microresearch/mycelium/01positive.jpg

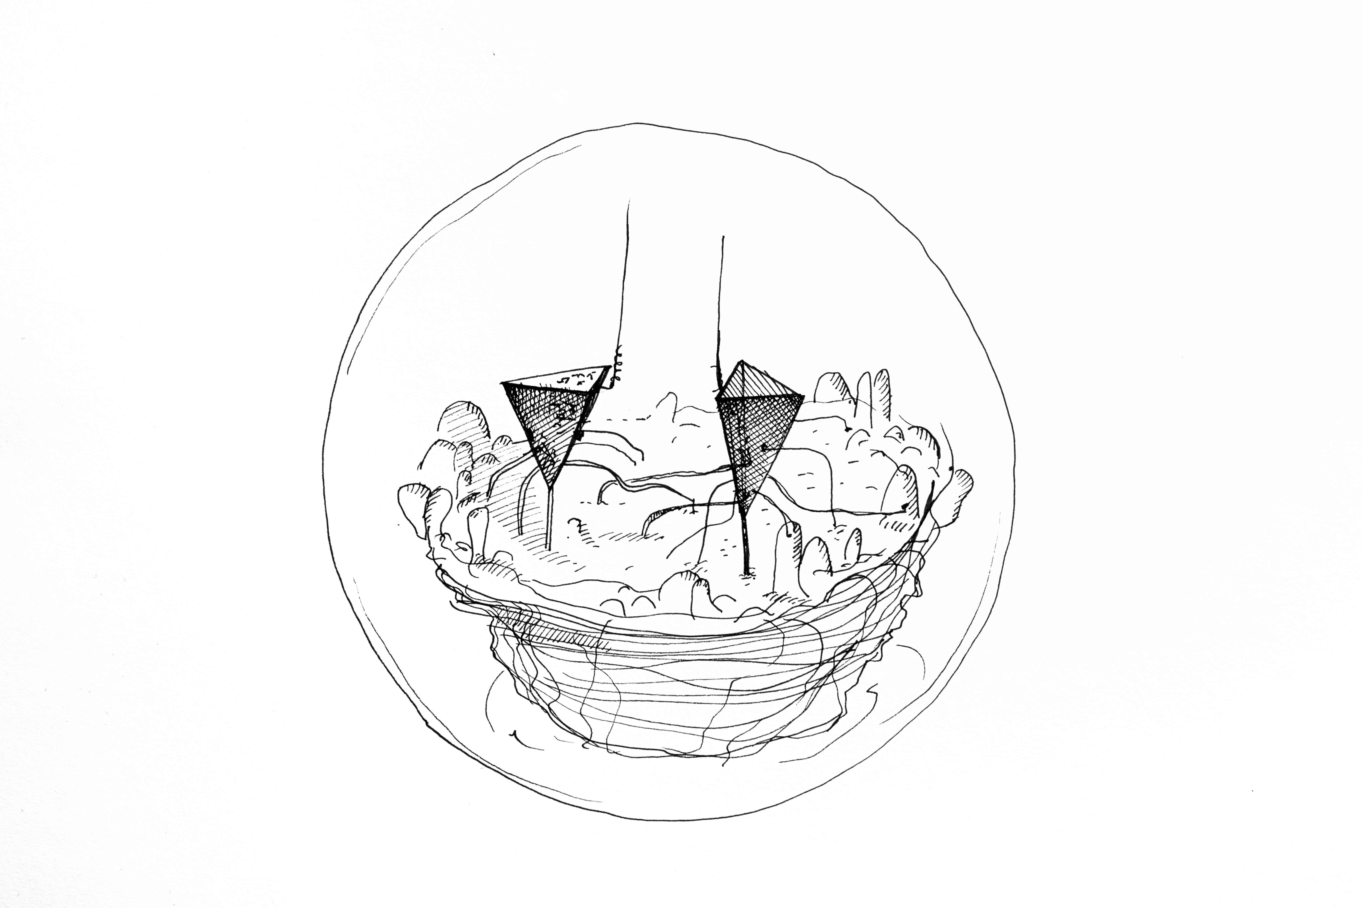
01positive.jpg
