microresearch/mycelium/simplestTX00.jpg

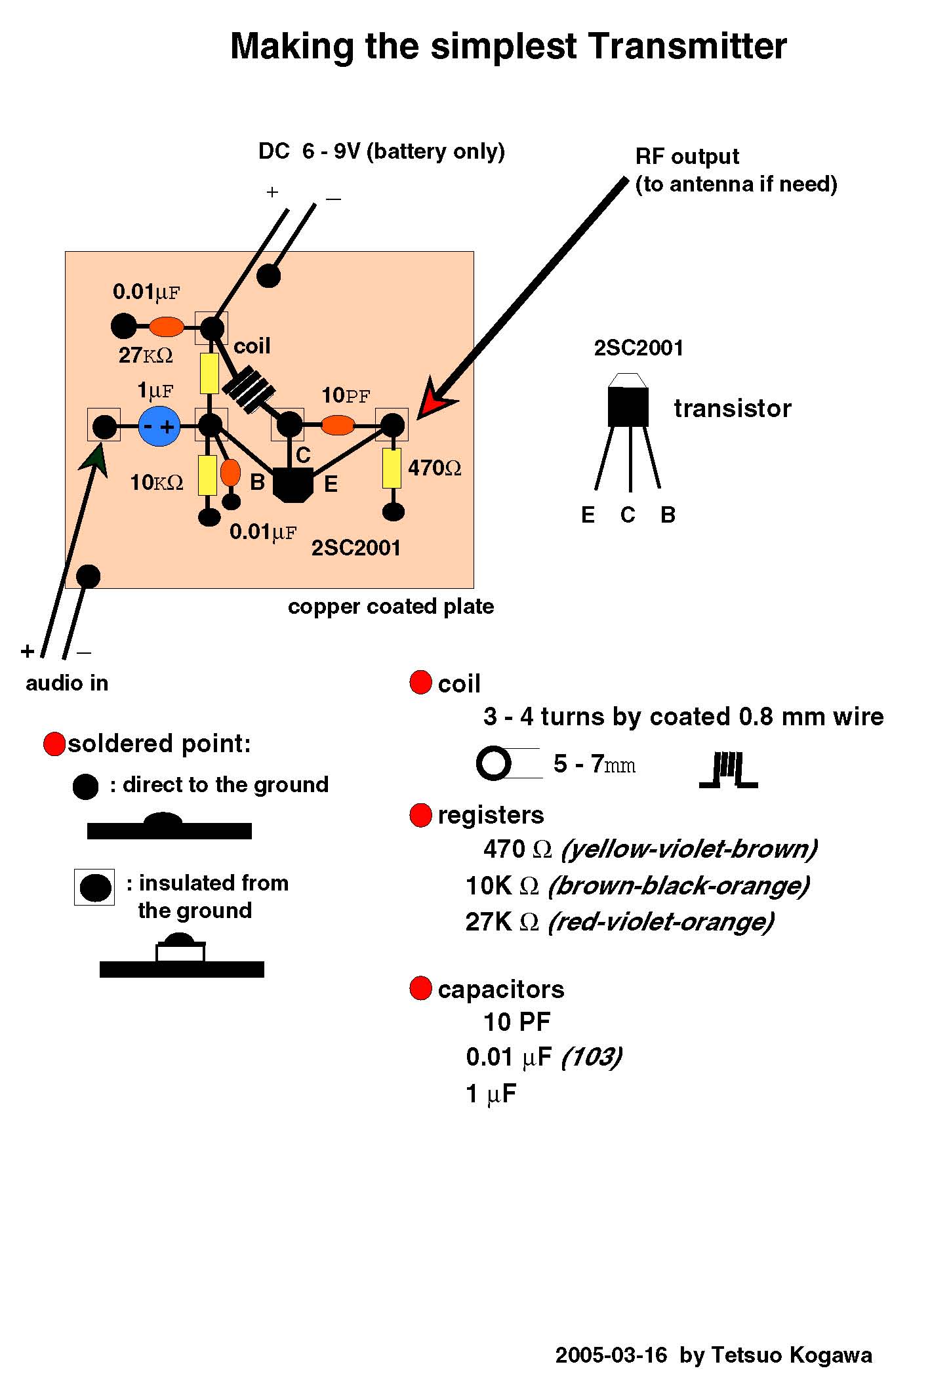
simplestTX00.jpg
