microresearch/mycelium/spy7-1.png

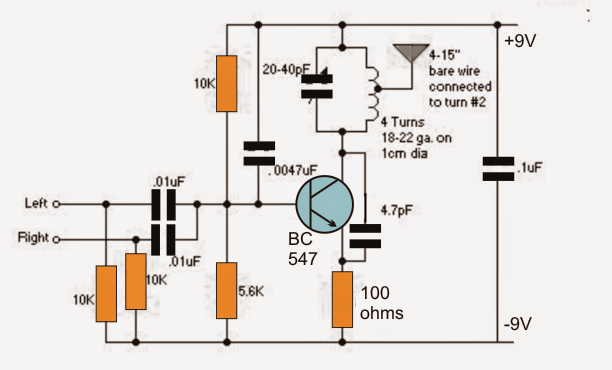
spy7-1.png
