microresearch/mycelium/myc_outline2.dxf

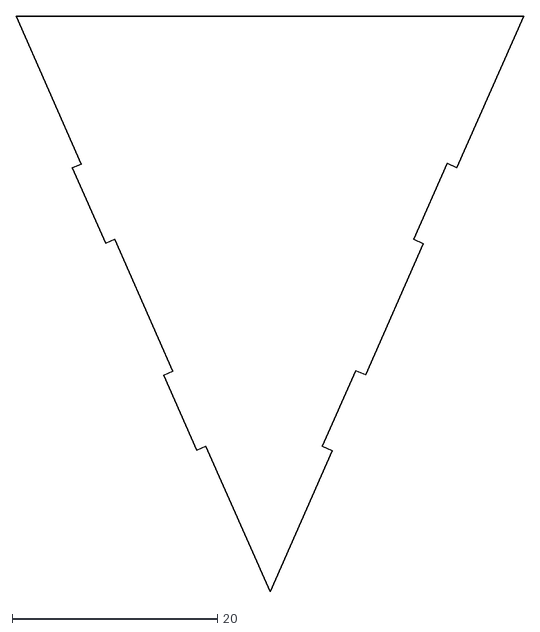
[picture p4: CAD file, 2018-06-28]
myc_outline2.dxf
49.5 x 56.1
