microresearch/mycelium/myc_outline3.dxf

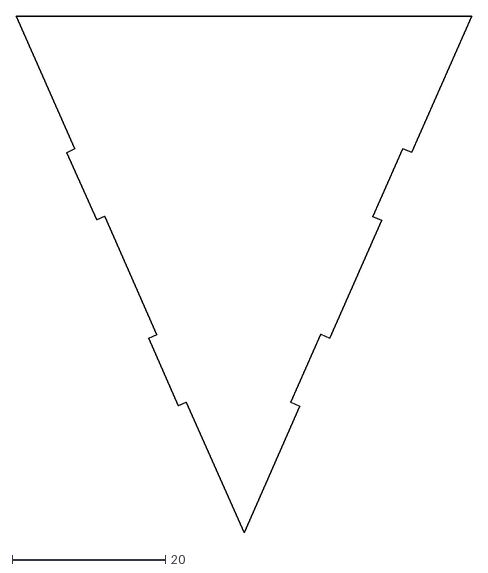
[picture p5: CAD file, 2018-06-28]
myc_outline3.dxf
59.4 x 67.4
