microresearch/mycelium/myc_small_schematic.pdf

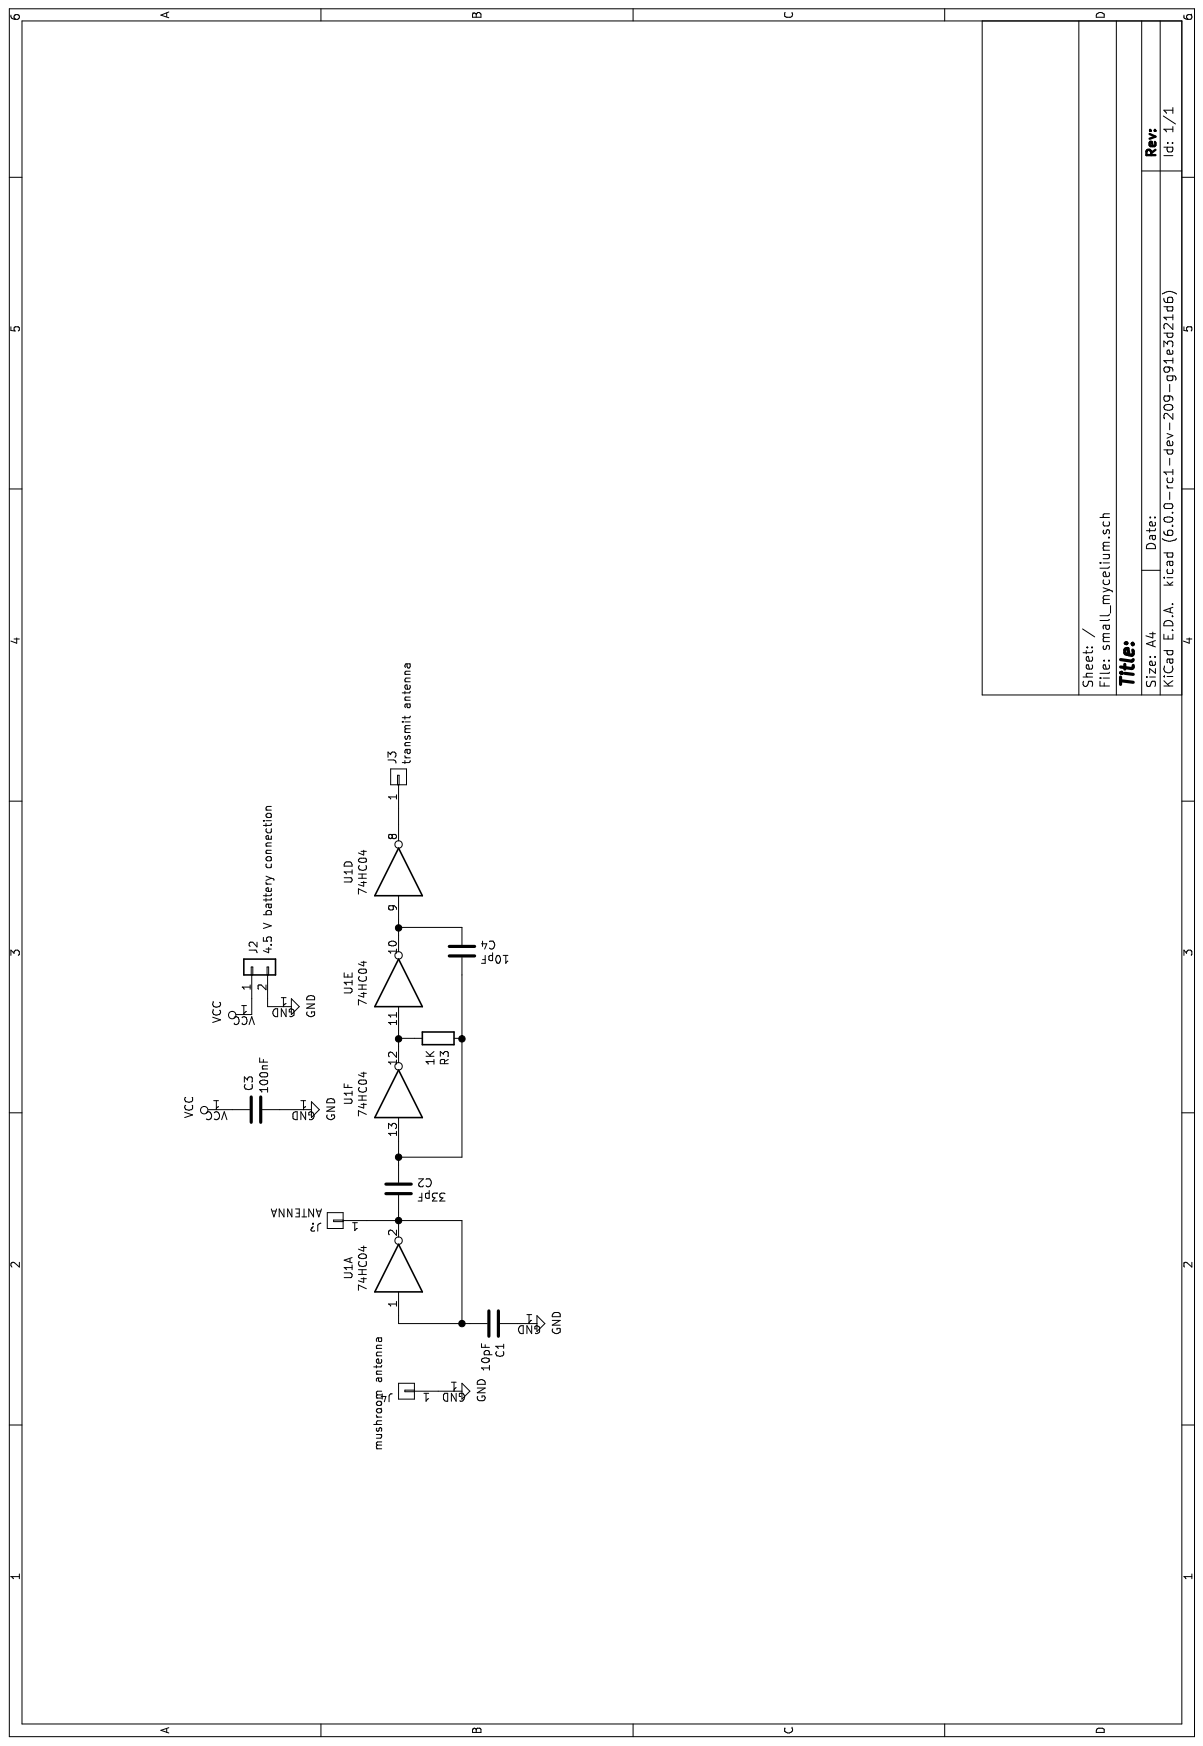
[picture p6: page 1]
