microresearch/mycelium/mycelium_pcb/earthboot/earthboot_schematic.pdf

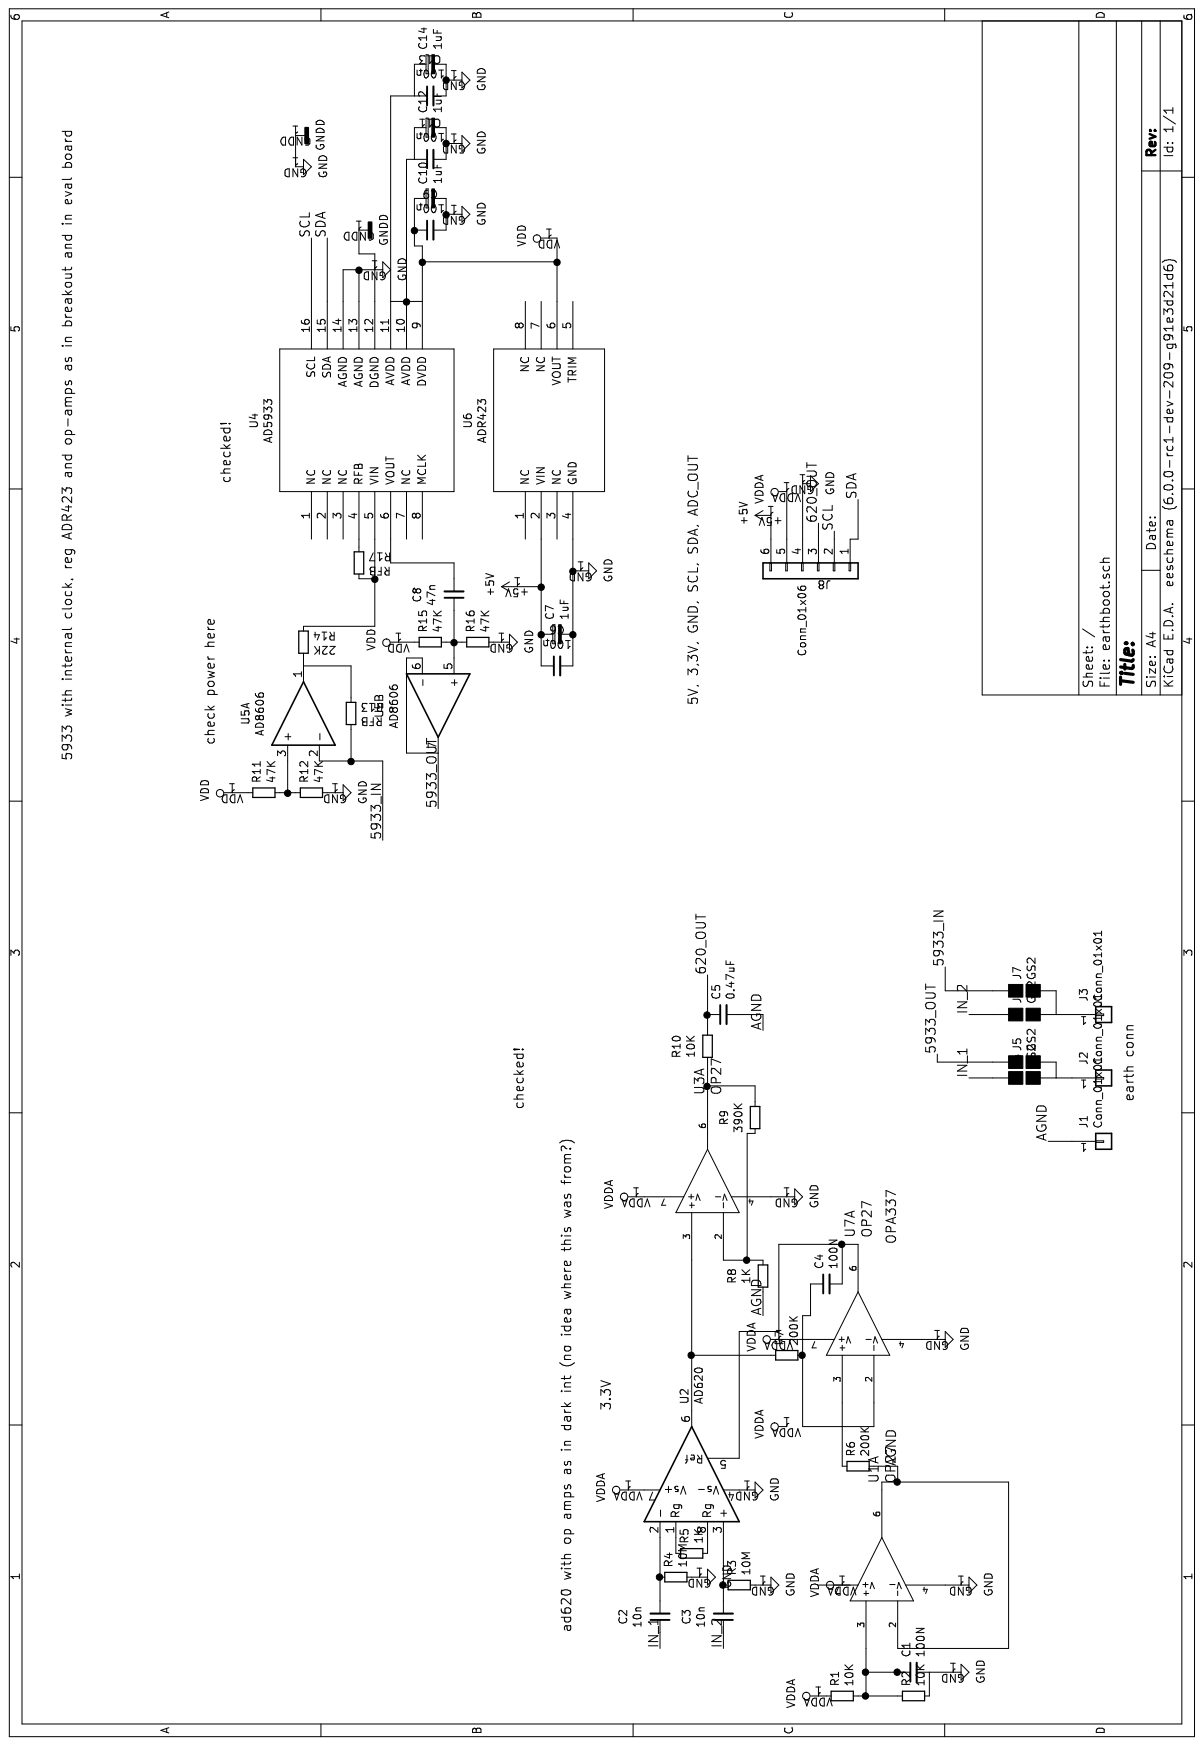
[picture p10: page 1]
