microresearch/mycelium/myc_small.pdf

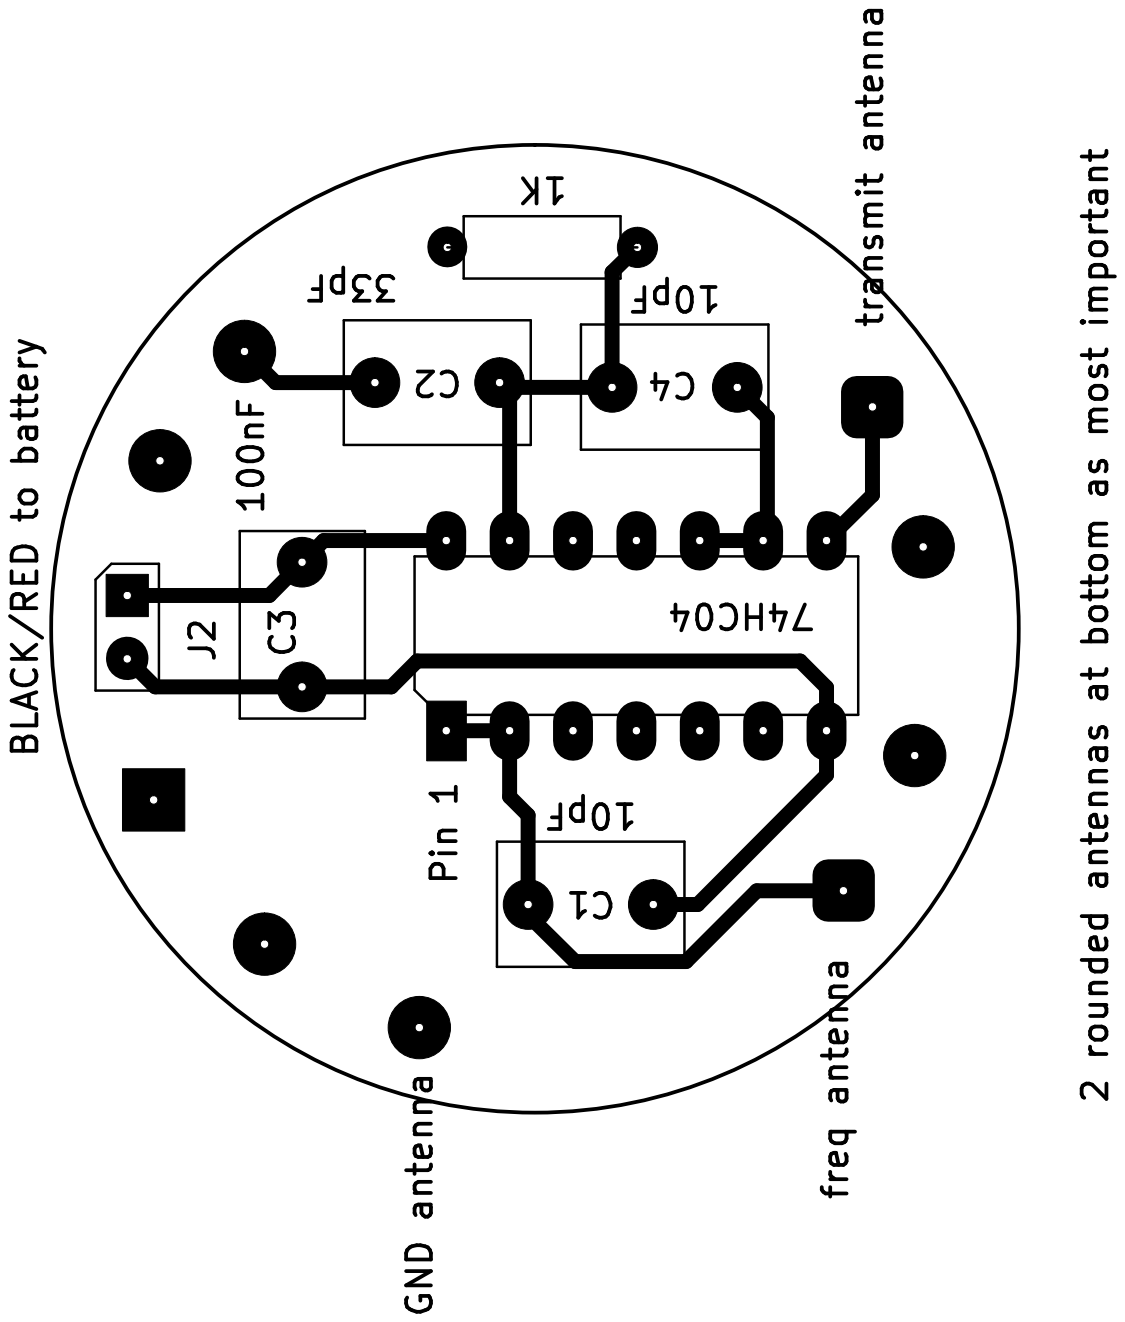
[picture p11: page 1]
