microresearch/mycelium/mycelium_pcb/mycelium_pcb_radio-F.SilkS.pdf

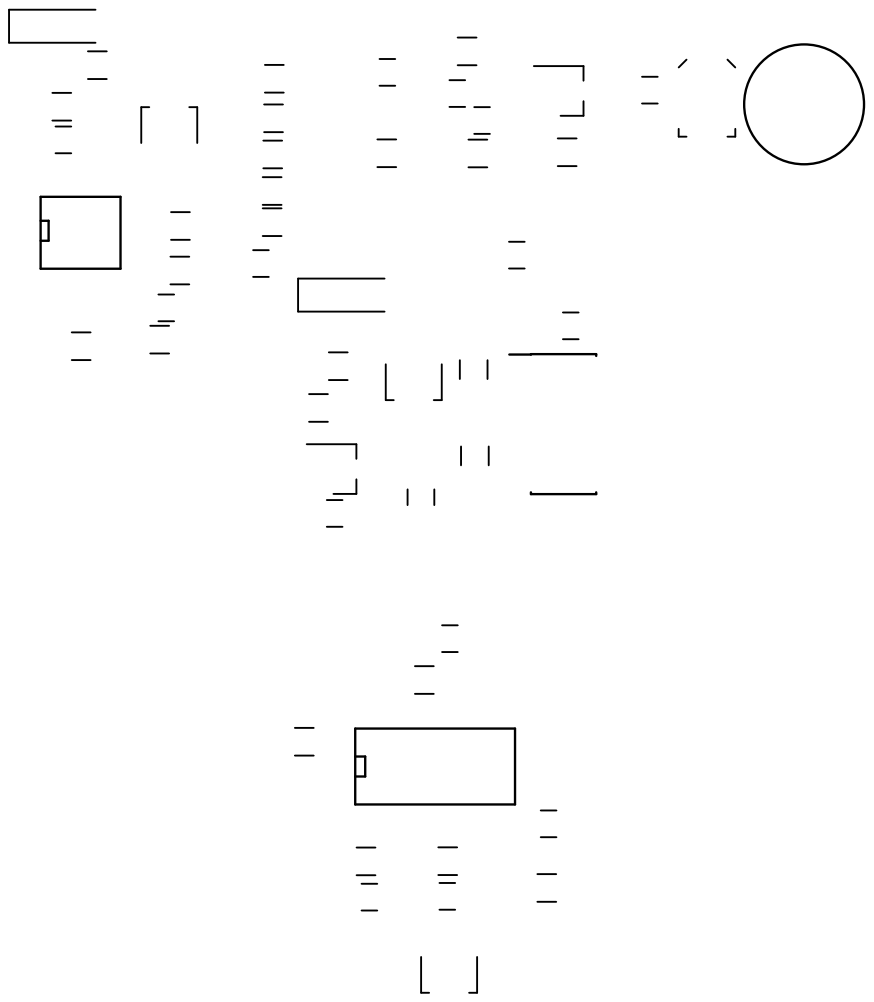
[picture p12: page 1]
