microresearch/mycelium/mycelium_pcb/micro.pdf

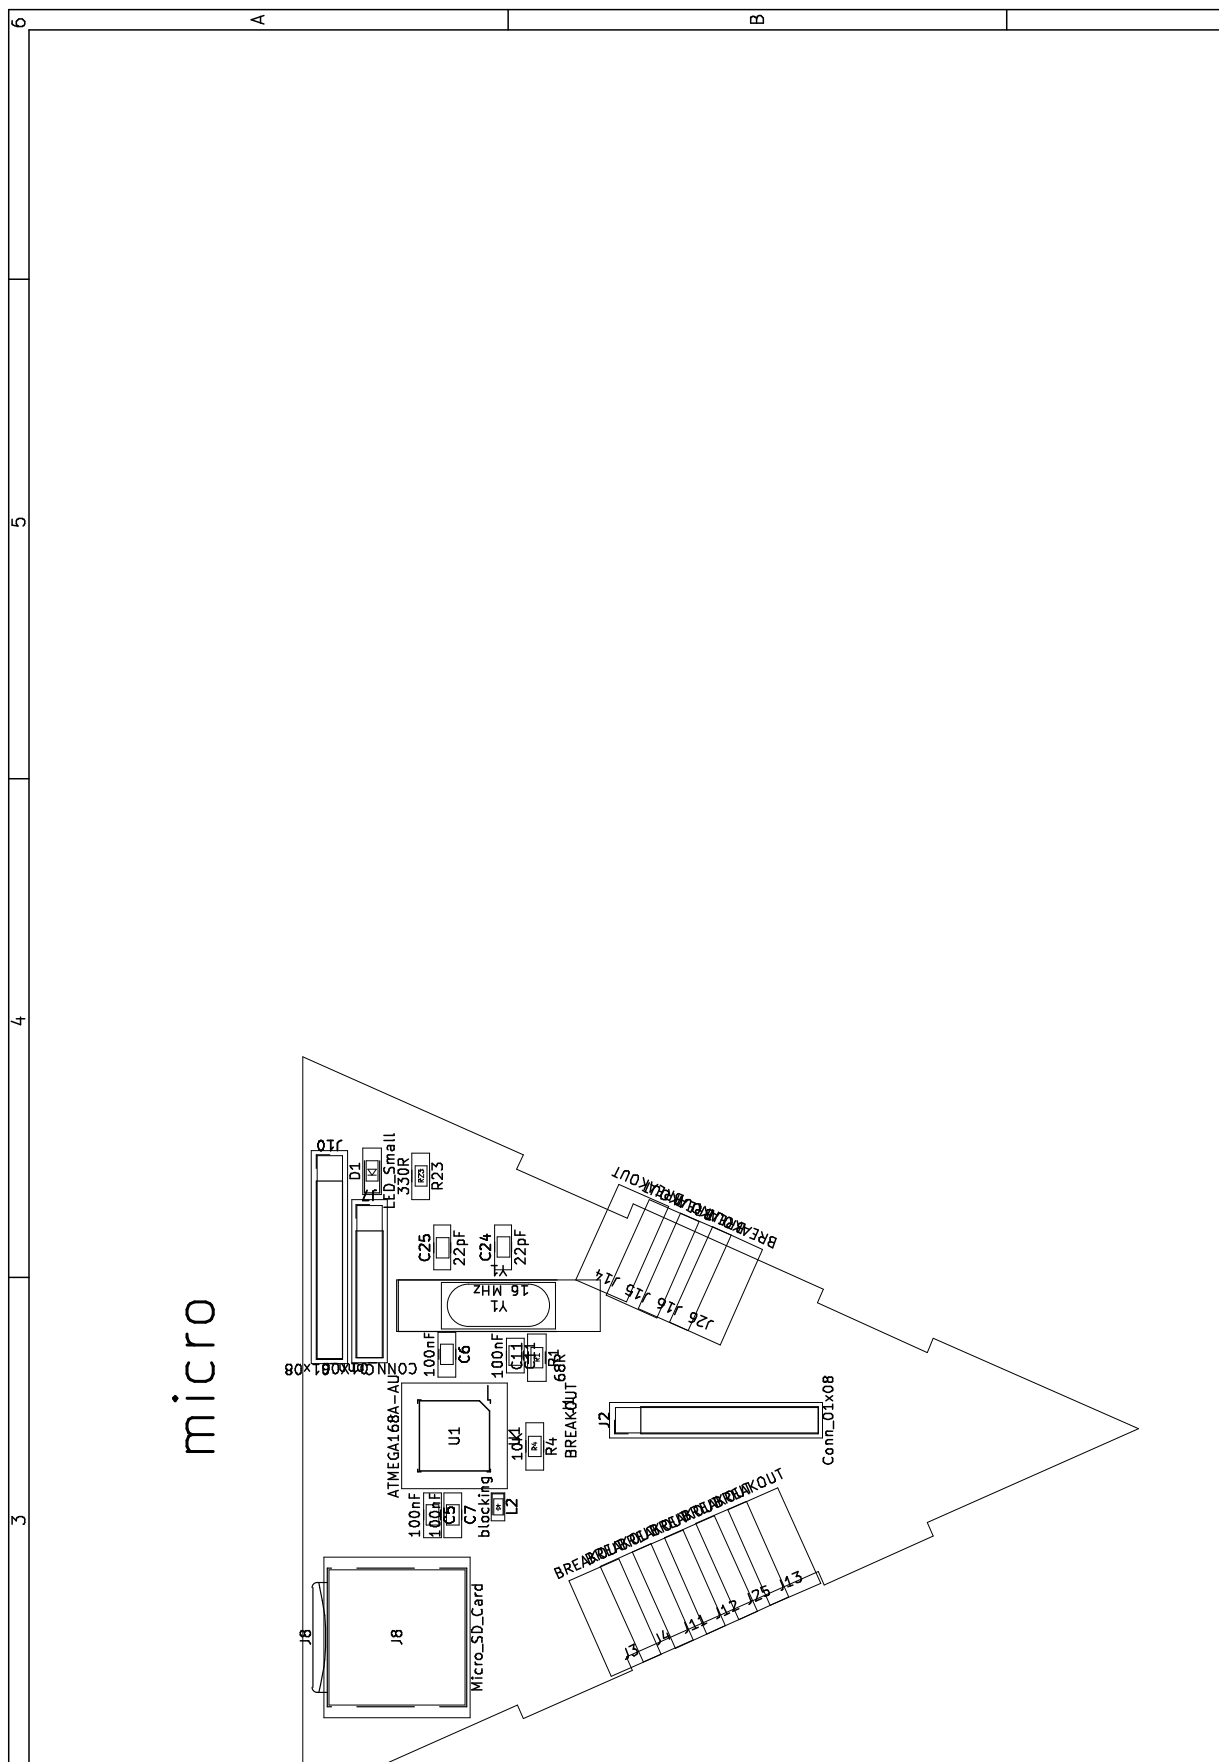
[picture p13: page 1]
