microresearch/mycelium/mycelium_pcb/radio.pdf

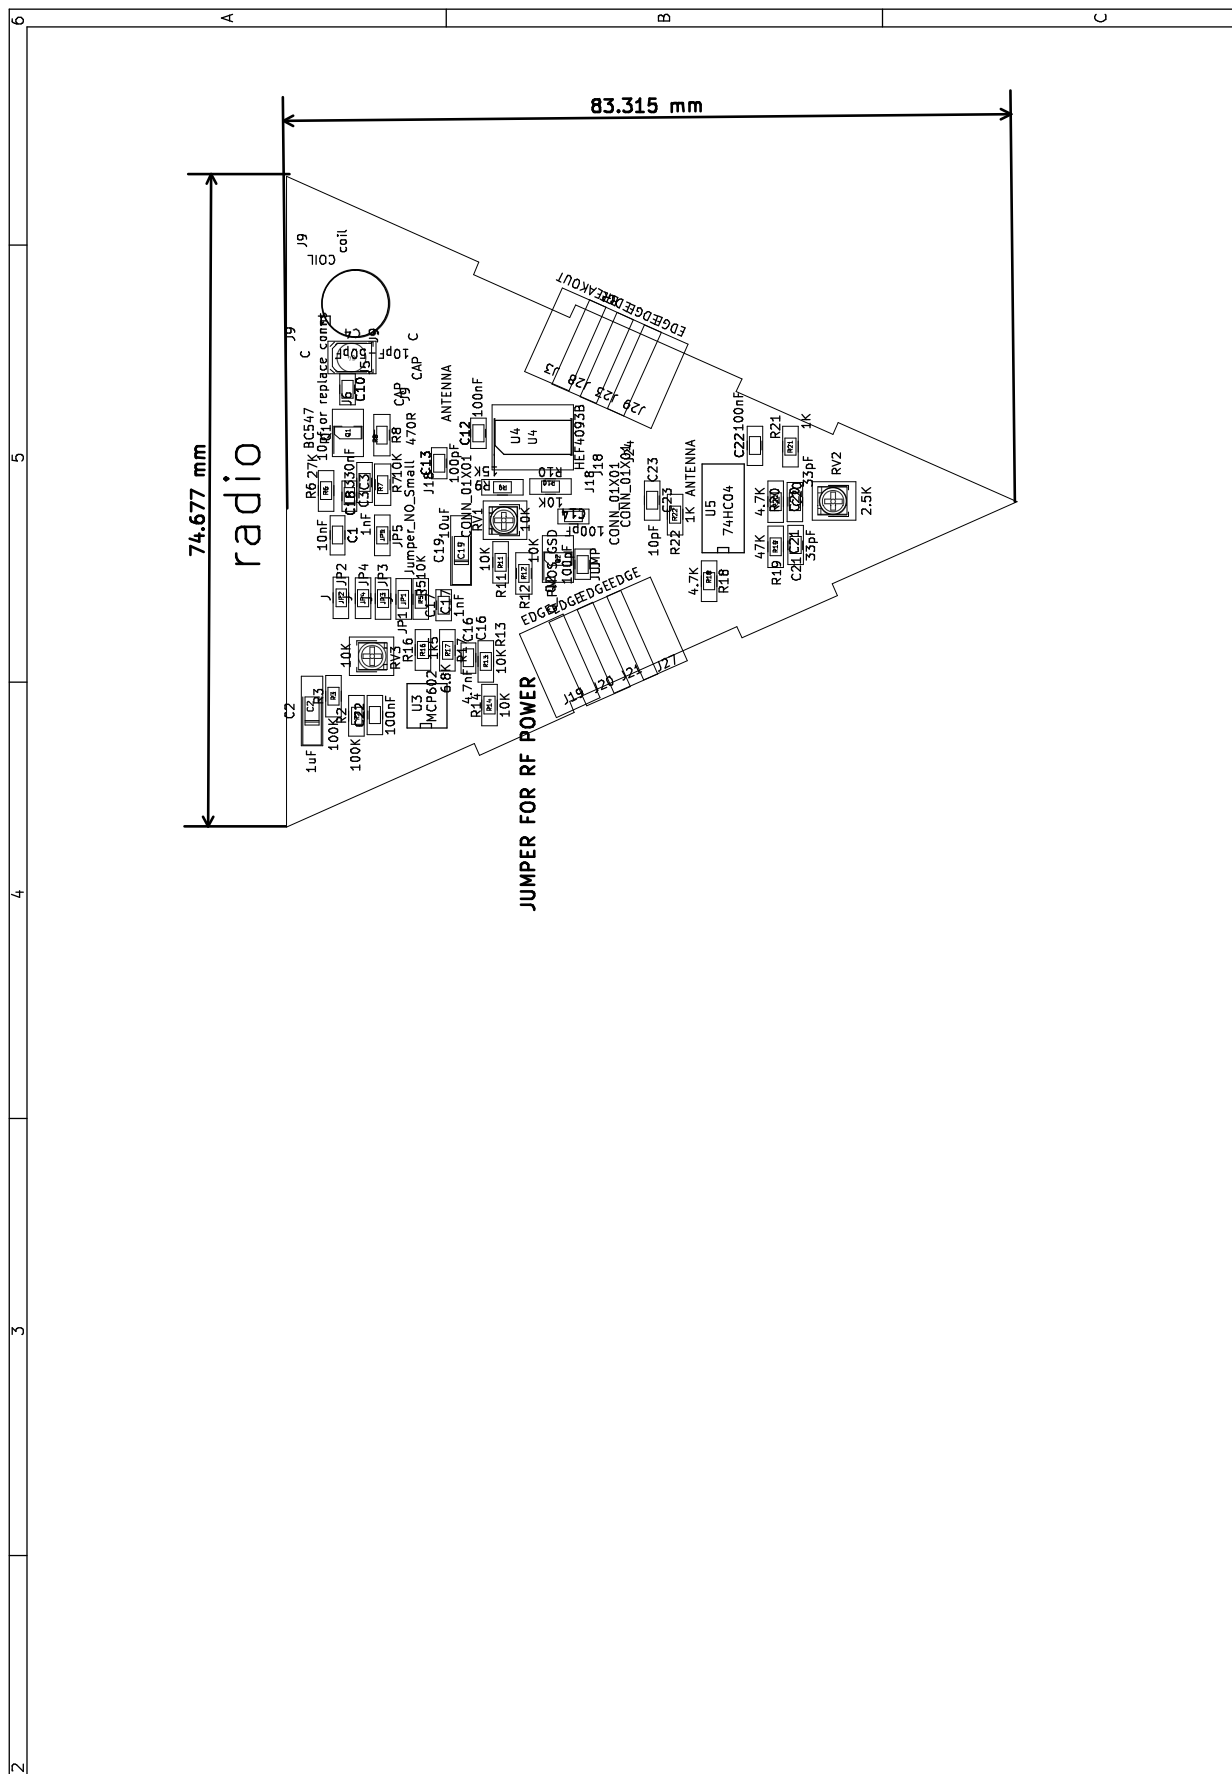
[picture p14: page 1]
