microresearch/mycelium/mycelium_pcb/sensor.pdf

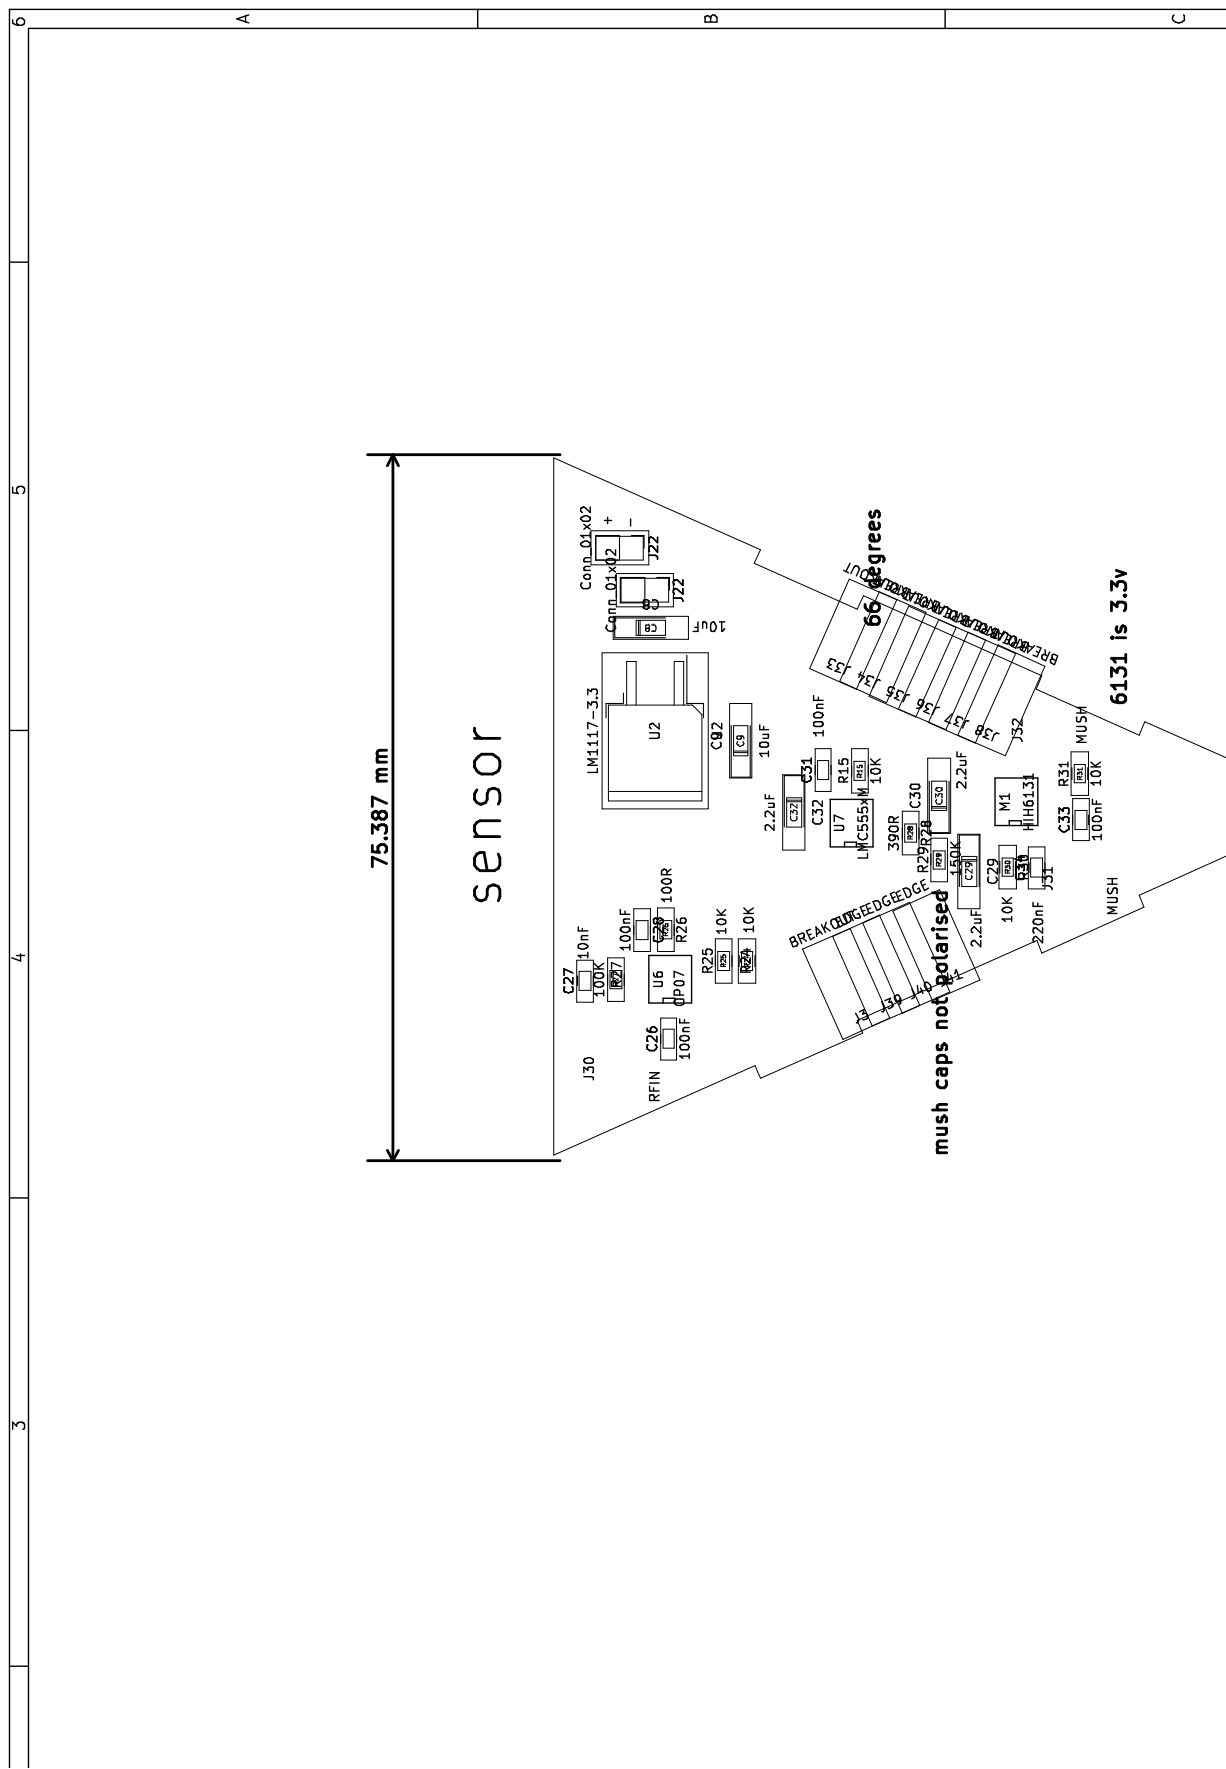
[picture p15: page 1]
