microresearch/mycelium/mycelium_pcb/earthboot/earthboot.kicad_pcb

## KiCad design mycelium_pcb/earthboot/earthboot.kicad_pcb (2018-07-23)

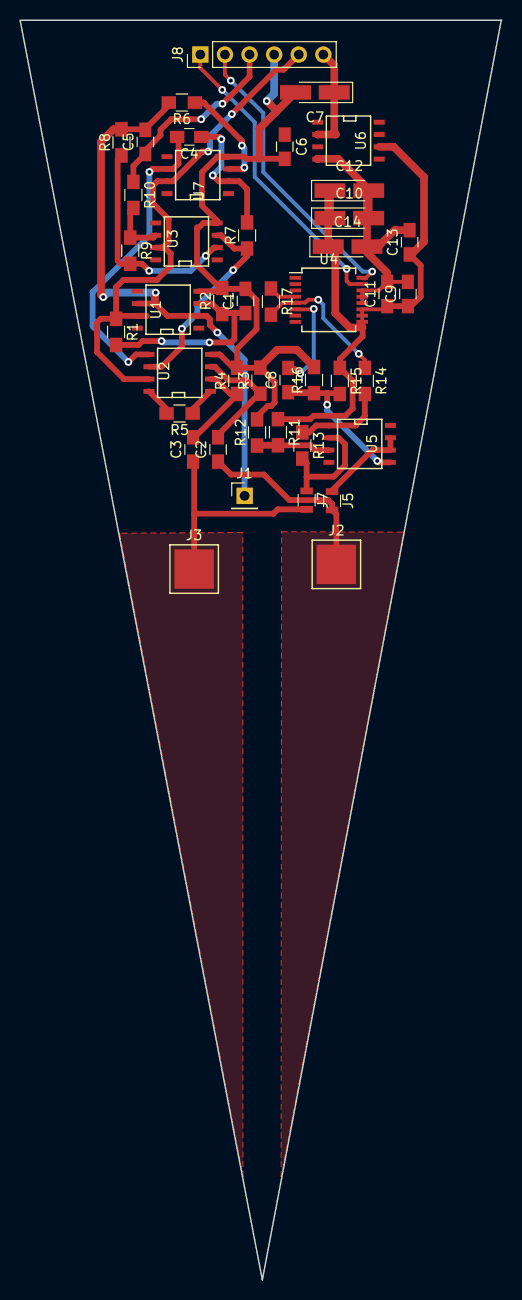
[picture p16: board earthboot.kicad_pcb from above]

Board: 2 copper layers, 49.7 x 130.0 mm, 44 parts (0 on the bottom side), 29 nets.

Parts:
C1, C4: 100N; C_0805_HandSoldering
C2, C3: 10n; C_0805_HandSoldering
C5: 0.47uF; C_0805_HandSoldering
C6, C9, C11, C13: 100n; C_0805_HandSoldering
C7, C10, C12, C14: 1uF; CP_Tantalum_Case-A_EIA-3216-18_Hand
C8: 47n; C_0805_HandSoldering
J1: Conn_01x01; Socket_Strip_Straight_1x01_Pitch2.54mm
J2, J3: Conn_01x01; 1Pin
J5, J7: GS2; R_0805
J8: Conn_01x06; Socket_Strip_Straight_1x06_Pitch2.54mm
R1, R2, R10: 10K; R_0805_HandSoldering
R3, R4: 10M; R_0805_HandSoldering
R5, R8: 1K; R_0805_HandSoldering
R6, R7: 200K; R_0805_HandSoldering
R9: 390K; R_0805_HandSoldering
R11, R12, R15, R16: 47K; R_0805_HandSoldering
R13, R17: RFB; R_0805_HandSoldering
R14: 22K; R_0805_HandSoldering
U1, U3, U7: OP27; SOIC-8-N
U2: AD620; SOIC-8-N
U4: AD5933; SSOP-16_5.3x6.2mm_Pitch0.65mm
U5: AD8606; SOIC-8-N
U6: ADR423; SOIC-8-N

Connections:
+5V: C6.1, C7.1, J8.6, U6.2
/620_OUT: C5.1, J8.3, R10.1
/5933_IN: J7.1, R13.2, U5.2
/5933_OUT: J5.1, U5.6, U5.7
/AGND: C5.2, J1.1, R6.2, R8.2, U1.2, U1.6
/SCL: J8.2, U4.16
/SDA: J8.1, U4.15
GND: C1.2, C6.2, C7.2, C9.2, C10.2, C11.2, C12.2, C13.2, C14.2, J8.4, R2.2, R3.2, R4.2, R12.2, R16.2, U1.4, U2.4, U3.4, U4.12, U4.13, U4.14, U6.4, U7.4
unnamed: C1.1, R1.2, R2.1, U1.3
unnamed: C3.2, R4.1, U2.2
unnamed: C2.2, R3.1, U2.3
unnamed: C4.1, R7.2, U7.2
unnamed: C4.2, U2.5, U7.6
unnamed: C8.1, R15.2, R16.1, U5.5
unnamed: C8.2, U4.6
unnamed: C2.1, J2.1, J5.2
unnamed: C3.1, J3.1, J7.2
unnamed: R5.1, U2.1
unnamed: R5.2, U2.8
unnamed: R6.1, U7.3
unnamed: R7.1, U2.6, U3.3
unnamed: R8.1, R9.2, U3.2
unnamed: R9.1, R10.2, U3.6
unnamed: R11.2, R12.1, U5.3
unnamed: R13.1, R14.2, U5.1
unnamed: R14.1, R17.2, U4.5
unnamed: R17.1, U4.4
VDD: C9.1, C10.1, C11.1, C12.1, C13.1, C14.1, R11.1, R15.1, U4.9, U4.10, U4.11, U6.6
VDDA: J8.5, R1.1, U1.7, U2.7, U3.7, U7.7
