microresearch/mycelium/mycelium_pcb/mycelium_pcb.kicad_pcb

## KiCad design mycelium_pcb/mycelium_pcb.kicad_pcb (2018-07-19)

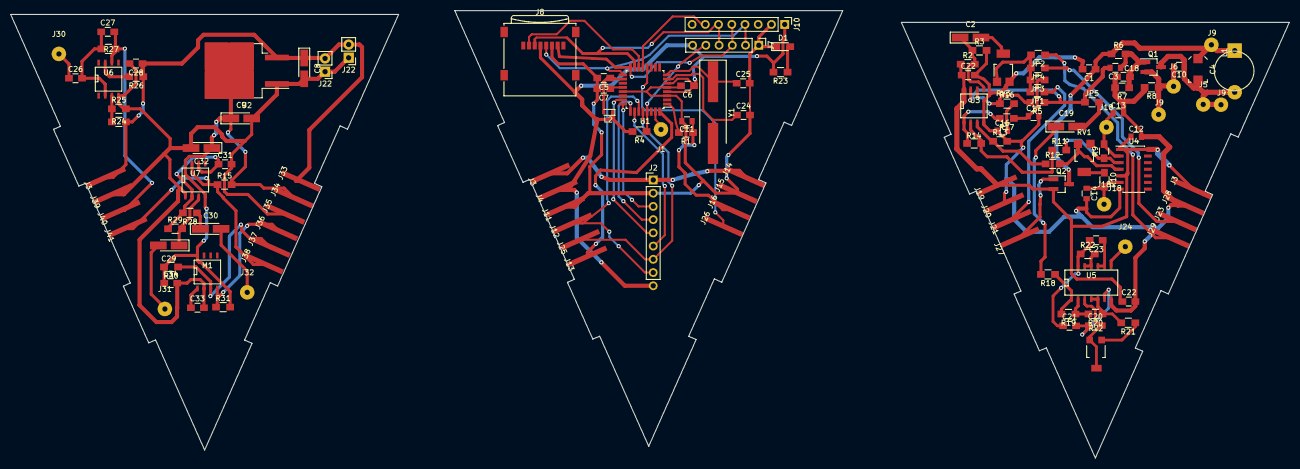
[picture p17: board mycelium_pcb.kicad_pcb from above]

Board: 2 copper layers, 245.6 x 85.9 mm, 134 parts (0 on the bottom side), 75 nets.

Parts:
C1, C27: 10nF; C_0805_HandSoldering
C2: 1uF; CP_Tantalum_Case-A_EIA-3216-18_Hand
C3: 1nF; C_0805_HandSoldering
C4: 10pF-50pF; C_Trimmer_Murata_TZC3
C5, C6, C7, C22, C22#2, C26, C28, C31, C33: 100nF; C_0805_HandSoldering
C8, C9, C19: 10uF; CP_Tantalum_Case-A_EIA-3216-18_Hand
C10: 10pf or replace conns; C_0805
C11, C12: 100nF; C_0805
C13, C14: 100pF; C_0805
C16: 10nF; C_0805
C17: 1nF; C_0805
C18: 330nF; C_0805
C20, C21: 33pF; C_0805_HandSoldering
C23: 10pF; C_0805_HandSoldering
C24, C25: 22pF; C_0805_HandSoldering
C29, C30, C32: 2.2uF; CP_Tantalum_Case-A_EIA-3216-18_Hand
C34: 220nF; C_0805_HandSoldering
D1: LED_Small; LED_0805_HandSoldering
J1: BREAKOUT; SolderWirePad_single_1mmDrill
J2, J10: Conn_01x08; Socket_Strip_Straight_1x08_Pitch2.54mm
J3, J3#2, J3#3, J4, J11, J12, J13, J14, J15, J16, J25, J26, J33, J34, J35, J36, J37, J38: BREAKOUT; SolderWirePad_single_SMD_5x10mm
J5, J6: CAP; SolderWirePad_single_1mmDrill
J7: CONN_01X06; Socket_Strip_Straight_1x06_Pitch2.54mm
J8: Micro_SD_Card; microSD_Card_Receptacle_Wurth_693072010801
J9, J9#2: C; SolderWirePad_single_1mmDrill
J9#3, J24: ANTENNA; SolderWirePad_single_1mmDrill
J18, J18#2, J18#3: CONN_01X01; SolderWirePad_single_1mmDrill
J19, J20, J21, J23, J27, J28, J29, J39, J40, J41: EDGE; SolderWirePad_single_SMD_5x10mm
J22, J22#2: Conn_01x02; Socket_Strip_Straight_1x02_Pitch2.54mm
J30: RFIN; SolderWirePad_single_1mmDrill
J31, J32: MUSH; SolderWirePad_single_1mmDrill
JP1, JP2, JP3, JP4: J; R_0805_HandSoldering
JP5: Jumper_NO_Small; R_0805_HandSoldering
L1: COIL; INDUCTOR_V
L2: blocking; D_0603
M1: HIH6131; SOIC-8-N
Q1: BC547; SOT-23_Handsoldering
Q2: Q_PMOS_GSD; SOT-23_Handsoldering
R1: 68R; R_0805_HandSoldering
R2, R3, R27: 100K; R_0805_HandSoldering
R4, R5, R7, R10, R11, R12, R13, R14, R15, R24, R25, R30, R31: 10K; R_0805_HandSoldering
R6: 27K; R_0805_HandSoldering
R8: 470R; R_0805_HandSoldering
R9: 15K; R_0805_HandSoldering
R16: 1k5; R_0805_HandSoldering
R17: 6.8K; R_0805_HandSoldering
R18, R20: 4.7K; R_0805_HandSoldering
R19: 47K; R_0805_HandSoldering
R21, R22: 1K; R_0805_HandSoldering
R23: 330R; R_0805_HandSoldering
R26: 100R; R_0805_HandSoldering
R28: 390R; R_0805_HandSoldering
R29: 150K; R_0805_HandSoldering
RV1: 10K; Potentiometer_Trimmer-23Breichelt_larger
RV2: 2.5K; Potentiometer_Trimmer-23Breichelt
RV3: 10K; Potentiometer_Trimmer-23Breichelt
U1: ATMEGA168A-AU; TQFP-32_7x7mm_Pitch0.8mm
U2: LM1117-3.3; TO-263-2
U3: MCP602; SOIC-8-N
U4: HEF4093B; SOIC-14_3.9x8.7mm_Pitch1.27mm
U5: 74HC04; SOIC-14_N
U6: OP07; SOIC-8-N
U7: LMC555xM; SOIC-8-N
Y1: 16 MHz; Crystal_SMD_HC49-SD_HandSoldering

Connections:
+3V3: C6.1, C9.1, C32.1, C34.1, J2.8, J4.1, J7.6, J8.4, J10.1, J34.1, L2.1, M1.8, R4.2, R15.2, R23.2, R30.2, R31.2, U1.4, U1.6, U2.2, U7.4, U7.8
+5V: J2.1, J3#3.1, J14.1
/ADC_CO2: J2.6, U1.26
/ADC_LIGHT: J2.5, U1.23
/ADC_MUSHROOM: J2.3, U1.24
/MISO: J7.3, J8.7, J10.5, U1.16
/MOSI: J7.4, J8.3, J10.6, U1.15
/MUSH_555: J13.1, U1.32
/PWM_LP_OUT: C11.1, J16.1, R1.1
/PWM_OUT: R1.2, U1.1
/RF_EN: J26.1, U1.12
/SCK: J7.2, J8.5, J10.4, U1.17
/SCL: J2.7, J25.1, U1.28
/SDA: J2.8, J12.1, U1.27
/SPARE_ADC: J2.4, U1.25
/SS: J8.2, U1.14
/TEMP_CS: J10.7, U1.13
/TX: J1.1, U1.31
/fm radio/555_OUTT: J29.1, JP2.1
/fm radio/HF_OUTT: J23.1, JP4.1
/fm radio/PWM_LF_OUTT: J21.1, JP1.1
/fm radio/RF_EN: J27.1, Q2.1
/fm radio/THER_OUT: C17.1, JP3.1, R17.1
/sensorboard/HF_OUTT: C27.2, J40.1, R27.1, U6.6
/sensorboard/MUSH_555: J38.1, J41.1, R15.1, U7.7
/sensorboard/SCL: J37.1, M1.3, R30.1
/sensorboard/SDA: J36.1, M1.4, R31.1
GND: C1.2, C3.2, C5.2, C6.2, C7.2, C8.2, C9.2, C11.2, C12.2, C13.2, C14.2, C16.1, C17.2, C22.2, C22#2.2, C24.2, C25.2, C28.2, C31.2, C32.2, C33.2, C34.2, D1.1, J2.2, J7.1, J8.6, J10.2, J11.1, J15.1, J20.1, J22.1, J22#2.1, J28.1, J35.1, J39.1, M1.2, R3.2, R7.2, R8.2, R13.2, R25.2, RV3.3, U1.3, U1.5, U1.21, U2.1, U3.4, U4.7, U5.7, U6.4, U7.1
unnamed: C1.1, C4.1, J9#2.1, L1.1, Q2.3, R6.1
unnamed: C2.1, R2.2, R3.1, U3.5
unnamed: C2.2, RV3.2
unnamed: C5.1, L2.2, U1.18
unnamed: C7.1, U1.20
unnamed: C4.2, C10.1, J5.1, J9.1, L1.2, Q1.3
unnamed: C10.2, J6.1, J9#3.1, Q1.2, R8.1
unnamed: C13.1, J18#2.1, R9.2, U4.2
unnamed: C14.1, J18.1, R10.2, U4.6
unnamed: C16.2, R16.2
unnamed: C3.1, C18.1, Q1.1, R6.2, R7.1
unnamed: C18.2, JP5.1, R5.1, U3.7
unnamed: C19.1, R18.2
unnamed: C19.2, JP5.2
unnamed: C20.1, C21.2, U5.6
unnamed: C20.2, RV2.2, RV2.3, U5.3
unnamed: C21.1, C23.2, R22.1, U5.13
unnamed: C23.1, U5.9, U5.10
unnamed: C24.1, U1.7, Y1.2
unnamed: C25.1, U1.8, Y1.1
unnamed: C26.1, J30.1
unnamed: C26.2, C27.1, R27.2, U6.2
unnamed: C29.1, R29.2, U7.3
unnamed: C29.2, J31.1
unnamed: C30.1, R28.1
unnamed: C30.2, J32.1
unnamed: C31.1, R28.2, R29.1, U7.2, U7.6
unnamed: C33.1, M1.1
unnamed: D1.2, R23.1
unnamed: J7.5, R4.1, U1.29
unnamed: J24.1, U5.8
unnamed: JP1.2, JP2.2, JP3.2, JP4.2, RV3.1
unnamed: R10.1, RV1.2
unnamed: R11.1, R14.2, U3.2
unnamed: R9.1, R11.2, U4.3
unnamed: R12.1, R13.1, U3.3
unnamed: R12.2, RV1.3, U4.4
unnamed: R14.1, R17.2, U3.1
unnamed: R5.2, R16.1, U3.6
unnamed: R18.1, R19.2, U5.1
unnamed: R19.1, R20.2, U5.2
unnamed: R20.1, R21.2, U5.4, U5.5
unnamed: R21.1, RV2.1
unnamed: R22.2, U5.11, U5.12
unnamed: R24.2, R25.1, U6.3
unnamed: R26.2, U6.7
VCC: C8.1, C12.1, C22.1, C22#2.1, C28.1, J3.1, J3#2.1, J19.1, J22.2, J22#2.2, J33.1, Q2.2, R2.1, R24.1, R26.1, U2.3, U3.8, U4.1, U4.5, U4.14, U5.14
