microresearch/mycelium/small_mycelium/small_mycelium_onesided.kicad_pcb

## KiCad design small_mycelium/small_mycelium_onesided.kicad_pcb (2022-09-18)

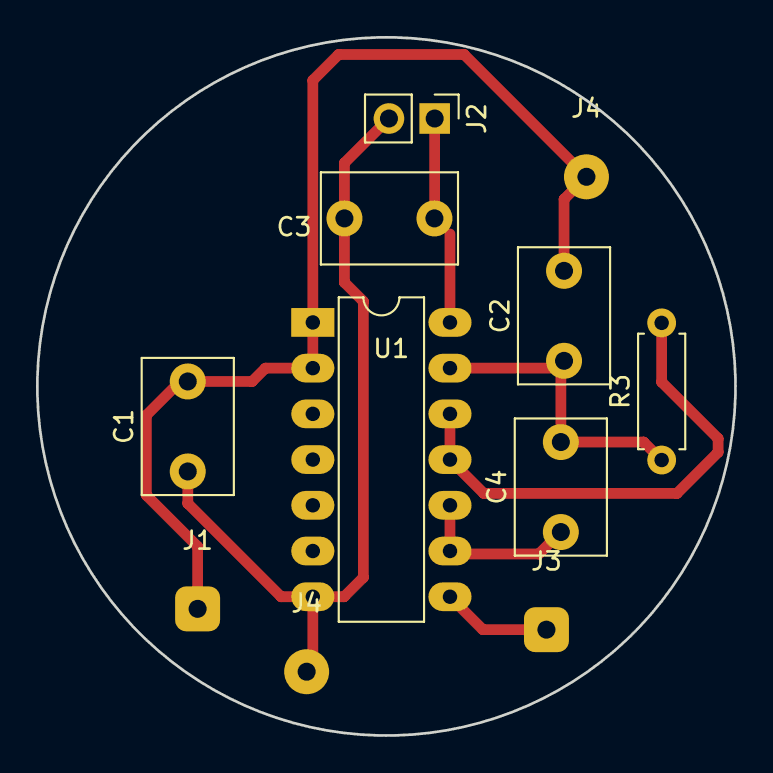
[picture p18: board small_mycelium_onesided.kicad_pcb from above]

Board: 2 copper layers, 38.8 x 38.8 mm, 11 parts (0 on the bottom side), 9 nets.

Parts:
C1, C4: 10pF; C_Disc_D7.5mm_W5.0mm_P5.00mm
C2: 33pF; C_Disc_D7.5mm_W5.0mm_P5.00mm
C3: 100nF; C_Disc_D7.5mm_W5.0mm_P5.00mm
J1, J3, J4, J4#2: SolderWirePad_single_1mmDrill
J2: Pin_Header_Straight_1x02_Pitch2.54mm
R3: 1K; R_Axial_DIN0207_L6.3mm_D2.5mm_P7.62mm_Horizontal
U1: 74HC04; DIP-14_W7.62mm_LongPads

Connections:
GND: C1.1, C3.2, J2.2, J4.1, U1.7
unnamed: U1.3, U1.4
unnamed: C2.1, C4.2, R3.1, U1.13
unnamed: C1.2, C2.2, J1.1, J4#2.1, U1.1, U1.2
unnamed: C4.1, U1.9, U1.10
unnamed: J3.1, U1.8
unnamed: U1.5, U1.6
unnamed: R3.2, U1.11, U1.12
VCC: C3.1, J2.1, U1.14
