microresearch/mycelium/software/myc_kansas.c

//
// Generates a Kansas City Standard compatible audio output
// on the selected PWM pin.
//

// 3-micro/CO2 SDcard -SOFT: SD, GATE, NOTE to put CO2 on ADC1!, *kansas. gate on?*

//

#define DEVIATION 8
#define howmany 16 // how smooth/average?
#define WHICH 1 // for ADC1 mushroom into fetadc


// SDCARD
#define SDCARD 1
#define ADC 1

//#define ADCMODES  // for ADC1 as doing switching of modus=cpu and plague - jumps up!

#define F_CPU 16000000UL 
#define FS 16000 // sample rate

#include <stdio.h>
#include <stdint.h>
#include <stdlib.h>
#include <math.h>
#include <avr/io.h>
#include <avr/eeprom.h>
#include <avr/interrupt.h>
#include <avr/pgmspace.h>
#include <util/delay.h>
#include <avr/sleep.h>
#include <avr/wdt.h>

#ifdef SDCARD
#include "sd_raw.h"
#include "sd_raw_config.h"
#include "partition.h"
#include "i2c_master.h"
#endif

#define BV(bit) (1<<(bit)) // Byte Value => converts bit into a byte value. One at bit location.
#define HEX__(n) 0x##n##UL
#define true 1
#define false 0
#define REFCLK (16000000.0/510.0)

#define MARK 1
#define MARK_CYCLES 8
#define MARK_FREQ 2400.0
#define MARK_INCR (4294967296.0*MARK_FREQ)/REFCLK

#define SPACE 0
#define SPACE_CYCLES 4
#define SPACE_FREQ 1200.0
#define SPACE_INCR (4294967296.0*SPACE_FREQ)/REFCLK

#define IDLE 65535

#define cbi(sfr, bit) (_SFR_BYTE(sfr) &= ~_BV(bit))
#define sbi(sfr, bit) (_SFR_BYTE(sfr) |= _BV(bit))

const uint8_t sine256[]  = {
  127, 130, 133, 136, 139, 143, 146, 149, 152, 155, 158, 161, 164, 167, 170, 173,
  176, 178, 181, 184, 187, 190, 192, 195, 198, 200, 203, 205, 208, 210, 212, 215,
  217, 219, 221, 223, 225, 227, 229, 231, 233, 234, 236, 238, 239, 240, 242, 243,
  244, 245, 247, 248, 249, 249, 250, 251, 252, 252, 253, 253, 253, 254, 254, 254,
  254, 254, 254, 254, 253, 253, 253, 252, 252, 251, 250, 249, 249, 248, 247, 245,
  244, 243, 242, 240, 239, 238, 236, 234, 233, 231, 229, 227, 225, 223, 221, 219,
  217, 215, 212, 210, 208, 205, 203, 200, 198, 195, 192, 190, 187, 184, 181, 178,
  176, 173, 170, 167, 164, 161, 158, 155, 152, 149, 146, 143, 139, 136, 133, 130,
  128, 124, 121, 118, 115, 111, 108, 105, 102,  99,  96,  93,  90,  87,  84 , 81,
  78,  76,  73,  70,  67,  64,  62,  59,  56,  54,  51,  49,  46,  44,  42,  39,
  37,  35,  33,  31,  29,  27,  25,  23,  21,  20,  18,  16,  15,  14,  12,  11,
  10,   9,   7,   6,   5,   5,   4,   3,   2,   2,   1,   1,   1,   0,   0,   0,
  0,   0,   0,   0,   1,   1,   1,   2,   2,   3,   4,   5,   5,   6,   7,   9,
  10,  11,  12,  14,  15,  16,  18,  20,  21,  23,  25,  27,  29,  31,  33,  35,
  37,  39,  42,  44,  46,  49,  51,  54,  56,  59,  62,  64,  67,  70,  73,  76,
  78,  81,  84,  87,  90,  93,  96,  99, 102, 105, 108, 111, 115, 118, 121, 124
};


//const uint8_t bits[]  = {0, 1, 0, 0, 0, 0, 0, 0, 0};  // Short for testing the Audio->Serial pcb

uint8_t bits[]  = {
  //  0,    0, 1, 1, 1, 1, 1, 1, 1,   1,1,1,1,1,1,1,1,1,1,1,1,1,1,1,1,1,1,1,1,1,1,1,1,1,1,1,1,1,1,1,1,1,1,1,
  //  0,    1, 0, 1, 1, 1, 1, 1, 1,   1,1,1,1,1,1,1,1,1,1,1,1,1,1,1,1,1,1,1,1,1,1,1,1,1,1,1,1,1,1,1,1,1,1,1,
  //  0,    1, 1, 0, 1, 1, 1, 1, 1,   1,1,1,1,1,1,1,1,1,1,1,1,1,1,1,1,1,1,1,1,1,1,1,1,1,1,1,1,1,1,1,1,1,1,1,
  //  0,    1, 1, 1, 0, 1, 1, 1, 1,   1,1,1,1,1,1,1,1,1,1,1,1,1,1,1,1,1,1,1,1,1,1,1,1,1,1,1,1,1,1,1,1,1,1,1,
  //  0,    1, 1, 1, 1, 0, 1, 1, 1,   1,1,1,1,1,1,1,1,1,1,1,1,1,1,1,1,1,1,1,1,1,1,1,1,1,1,1,1,1,1,1,1,1,1,1,
  //  0,    1, 1, 1, 1, 1, 0, 1, 1,   1,1,1,1,1,1,1,1,1,1,1,1,1,1,1,1,1,1,1,1,1,1,1,1,1,1,1,1,1,1,1,1,1,1,1,
  //  0,    1, 1, 1, 1, 1, 1, 0, 1,   1,1,1,1,1,1,1,1,1,1,1,1,1,1,1,1,1,1,1,1,1,1,1,1,1,1,1,1,1,1,1,1,1,1,1,
  //  0,    1, 1, 1, 1, 1, 1, 1, 0,   1,1,1,1,1,1,1,1,1,1,1,1,1,1,1,1,1,1,1,1,1,1,1,1,1,1,1,1,1,1,1,1,1,1,1,
  //  0,    1, 1, 1, 1, 1, 1, 0, 1,   1,1,1,1,1,1,1,1,1,1,1,1,1,1,1,1,1,1,1,1,1,1,1,1,1,1,1,1,1,1,1,1,1,1,1,
  //  0,    1, 1, 1, 1, 1, 0, 1, 1,   1,1,1,1,1,1,1,1,1,1,1,1,1,1,1,1,1,1,1,1,1,1,1,1,1,1,1,1,1,1,1,1,1,1,1,
  //  0,    1, 1, 1, 1, 0, 1, 1, 1,   1,1,1,1,1,1,1,1,1,1,1,1,1,1,1,1,1,1,1,1,1,1,1,1,1,1,1,1,1,1,1,1,1,1,1,
  //  0,    1, 1, 1, 0, 1, 1, 1, 1,   1,1,1,1,1,1,1,1,1,1,1,1,1,1,1,1,1,1,1,1,1,1,1,1,1,1,1,1,1,1,1,1,1,1,1,
  //  0,    1, 1, 0, 1, 1, 1, 1, 1,   1,1,1,1,1,1,1,1,1,1,1,1,1,1,1,1,1,1,1,1,1,1,1,1,1,1,1,1,1,1,1,1,1,1,1,
  //  0,    1, 0, 1, 1, 1, 1, 1, 1,   1,1,1,1,1,1,1,1,1,1,1,1,1,1,1,1,1,1,1,1,1,1,1,1,1,1,1,1,1,1,1,1,1,1,1,
  //  0,    0, 1, 1, 1, 1, 1, 1, 1,   1,1,1,1,1,1,1,1,1,1,1,1,1,1,1,1,1,1,1,1,1,1,1,1,1,1,1,1,1,1,1,1,1,1,1,
  0,    0, 0, 0, 0, 0, 0, 0, 0,   1, 1,1,1,1,1,1
};

uint16_t sequencelength = sizeof(bits);

volatile uint16_t bitp = IDLE;

ISR(TIMER2_OVF_vect) {
  static uint32_t accu = 0;    // phase accumulator
  static uint32_t  incr = MARK_INCR;    // accumulator increment value
  static uint8_t firstcycle = true;
  static uint8_t cyclecnt = 1;
  uint8_t isin;                   // index into sine table

  accu = accu + incr; // soft DDS, phase accu with 32 bits
  isin = accu >> 24;   // use upper 8 bits for phase accu as frequency information
  OCR2B = sine256[isin];;    // read from sine table and send vauleto PWM DAC

  if (isin > 127) {
    if (firstcycle) {
      firstcycle = false;
      cyclecnt--;
      if (cyclecnt == 0) {
        if ((bitp == IDLE)  || (bits[bitp++] == MARK)) {
          incr = MARK_INCR;
          cyclecnt = MARK_CYCLES;
	  //          sbi(PORTD, BITPIN);
        } else {
          incr = SPACE_INCR;
          cyclecnt = SPACE_CYCLES;
	  //          cbi(PORTD, BITPIN);
        }
        if (bitp >= sequencelength) bitp = IDLE;
      }
    }
  } else firstcycle = true;
}

void adc_init(void)
{
  	cbi(ADMUX, REFS1); 
	sbi(ADMUX, REFS0); // AVCC
	//	sbi(ADMUX, ADLAR); //8 bits
	sbi(ADCSRA, ADPS2);
	//	sbi(ADCSRA, ADPS1); // change speed here! now div by 64
	//	sbi(ADCSRA, ADPS0); // change speed here!

	sbi(ADCSRA, ADEN);
	DDRC = 0x00;
	PORTC = 0x00;
	// settle on 10 bits
}

unsigned int adcread10(short channel){
  unsigned int ADresult;
  ADMUX &= 0xF8; // clear existing channel selection                
    ADMUX |=(channel & 0x07); // set channel/pin
  ADCSRA |= (1 << ADSC);  // Start A2D Conversions 
  loop_until_bit_is_set(ADCSRA, ADIF); /* Wait for ADIF, will happen soon */
  ADresult = ADCL;
  ADresult |= ((int)ADCH) << 8;
  return(ADresult);
}


void initall() {
  cli();
  DDRD=0x08;  // PD3
  DDRB|=0x01; // PB0 and for SD card  

  adc_init();
  
  // Timer2 Clock Prescaler to /1
  sbi (TCCR2B, CS20);
  cbi (TCCR2B, CS21);
  cbi (TCCR2B, CS22);

  // Timer2 PWM Mode set to Phase Correct PWM
  cbi (TCCR2A, COM2A0);  // Clear the Compare Match
  sbi (TCCR2A, COM2A1);

  cbi (TCCR2A, COM2B0);  // Clear the Compare Match
  sbi (TCCR2A, COM2B1);


  sbi (TCCR2A, WGM20);  // Mode 1, Phase correct PWM
  cbi (TCCR2A, WGM21);
  cbi (TCCR2B, WGM22);

  OCR2B = 128;

  // disable interrupts to avoid timing distortion
  cbi (TIMSK0, TOIE0);             // disable Timer0 aka delay()
  sbi (TIMSK2, TOIE2);             // enable Timer2 Interrupt
  sei(); // we needed to add this!
}

void Delay1ms() {
  for (uint16_t j = 0; j < 2500; j++) __asm__ __volatile__ ("nop\n\t");
}

void wait() {
  for (uint16_t i=0; i<200; i++) Delay1ms();
}

void Send1(uint8_t v) {
  while (bitp != IDLE);
  bits[1] = !(v & 0x01);
  bits[2] = !(v & 0x02);
  bits[3] = !(v & 0x04);
  bits[4] = !(v & 0x08);
  bits[5] = !(v & 0x10);
  bits[6] = !(v & 0x20);
  bits[7] = !(v & 0x40);
  bits[8] = !(v & 0x80);
  bitp = 0;
}


void Send(uint8_t v) {
    for (uint16_t i=0; i<6; i++) Send1(v);
    wait();
}

const uint32_t SIZEY=2000000000; // 2 GB say


void main() {
  initall();
  uint8_t value=0;
  uint32_t offset=0, x;
  
#ifdef SDCARD
    while(1){    // outer loop for SD-cardery
      //      cli();
      if(!sd_raw_init())
      {
	//	printf("NO raw");
	continue;
      }

    struct partition_struct* partition = partition_open(sd_raw_read,
							sd_raw_read_interval,
							sd_raw_write,
							sd_raw_write_interval,
							0
							);

    if(!partition)
      {
	partition = partition_open(sd_raw_read,
				   sd_raw_read_interval,
				   sd_raw_write,
				   sd_raw_write_interval,
				   -1
				   );
	if(!partition)
	  {
	    //	printf("NO part");
	    continue;          
	  }
      }
    //    sei();
    //    printf("OPENED");
#endif

      while(1){
#ifdef SDCARD
    // write a value to SD from xxxx
    // read and send values from SD

	// TODO: read value
	value=adcread10(ADC)>>2; // 8 bits
	
    sd_raw_write(offset++, &value, 1);
    if (offset>SIZEY) offset=0;
    for (x=0;x<offset;x++){
      sd_raw_read(x, &value, 1);
      Send(value);
    }

#endif
      }
    
#ifdef SDCARD
  }
#endif
  
}
