microresearch/mycelium/(commit log)

2018-06-28 first myc
    [myc_outline2.dxf, myc_outline3.dxf, mycelium_pcb.kicad_pcb, mycelium_pcb.sch]
2018-07-03 break down schematics
    [fm radio section.sch, mycelium_pcb.sch, sensorboard.sch]
2018-07-04 to check all
    [fm radio section.sch, mycelium_pcb.sch, sensorboard.sch]
2018-07-18 adding earthboot device
    [earthboot.kicad_pcb, earthboot.sch, mycelium_pcb.kicad_pcb]
2018-07-19 ready to split
    [earthboot.kicad_pcb, fm radio section.sch, mycelium_pcb.kicad_pcb]
2018-07-20 dixed 5933 size
    [earthboot.kicad_pcb, earthboot.sch, earthboot_withnewsoldermask.kicad_pcb]
2018-07-23 gerbers etc...
    [earthboot_withnewsoldermask.kicad_pcb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]
2018-08-13 update all else...
    [fm radio section.sch, mycelium_pcb.sch, sensorboard.sch]
2018-08-13 for layouts
    [fm radio section.sch, mycelium_pcb.sch, mycelium_pcb_micro.kicad_pcb, mycelium_pcb_radio.kicad_pcb, mycelium_pcb_sensor.kicad_pcb, sensorboard.sch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]
2018-08-15 fixes to earth
    [earthboot.sch]
2018-08-21 MAX31865 reading SPI addded
2018-08-30 added audio test bed
2018-10-21 mini mycelium for workshop
    [small_mycelium.kicad_pcb, small_mycelium.sch]
2018-10-22 small mycelium transmission circuit for workshop
